Moonwolf711/generator-anc/firmware/README.md

# generator-anc firmware (Teensy 4.0/4.1)

Real-time engine-order ANC for a **Champion 4250** (224cc single-cylinder inverter genset)
on a Teensy 4.x + PJRC Audio Shield. The controller is `../include/eoc/engine_order_canceller.hpp`
(a synced copy lives in `generator_anc_teensy/` so the Arduino sketch can include it).

## What it does

- Reads the **error mic** through the Audio Shield codec.
- Reads the **spark tach** (one pulse/revolution) on an interrupt; interpolates crank angle and
  **phase-locks** the controller every audio block — the coherence that makes real cancellation work.
- Adapts a per-harmonic (cos/sin) anti-noise signal and plays it out the codec to a power amp/speaker.
- Tracks RPM live (essential — this is an inverter genset; engine speed swings with load).

## Bill of materials

| part | note |
|---|---|
| Teensy 4.0 or 4.1 | 600 MHz M7, the compute |
| PJRC Audio Shield (rev D, SGTL5000) | clean mic-in + line-out codec |
| Inductive spark pickup | clamps on the plug wire (timing-light style); no engine mod |
| Tach conditioning | clamp + comparator/transistor → **0/3.3 V** pulse (see below) |
| Electret/measurement mic | the error mic, into LINEIN |
| Class-D power amp + woofer | must reproduce ~30–360 Hz cleanly (a small subwoofer) |

## Wiring

```
spark plug wire ──[inductive clamp]──[diode+RC clamp]──[comparator → 0/3.3V]── Teensy pin 2 (TACH_PIN)
error mic ── Audio Shield LINEIN (L)
Audio Shield LINEOUT (L) ── power amp ── anti-noise speaker (near the error mic)
Teensy + Audio Shield: stack per PJRC pinout (I2S + I2C)
IMP 2 DI with GROUND LIFT on the line-level run to the amp -> kills the genset's 60 Hz ground-loop hum
```

**SAFETY — read this:**
- Teensy 4.x pins are **3.3 V only and NOT 5 V tolerant**. Never connect raw ignition voltage (kV)
  to a pin. The inductive pickup + clamp + comparator must deliver a clean 0–3.3 V pulse.
- A running generator emits **carbon monoxide** — bench/calibrate outdoors or with the engine off.
- The genset ground is dirty/possibly bonded-neutral; isolate line-level gear (the IMP 2 ground-lift)
  and don't create a shock path between the genset and your bench supply.

## Build

1. Install **Teensyduino** (Arduino IDE add-on).
2. Open `generator_anc_teensy/generator_anc_teensy.ino`. The controller header is already beside it.
   (To re-sync after editing the core: `cp ../../include/eoc/engine_order_canceller.hpp generator_anc_teensy/`.)
3. Board: Teensy 4.0/4.1, USB Type: Serial, CPU 600 MHz. Upload.
4. Open Serial Monitor (115200) — you'll see `f0`, RPM, per-order amplitudes, CPU%, and tach lock.

## No Audio Shield? (Teensy MQS + ADC) — `#define USE_AUDIO_SHIELD 0`

Teensy 4.0 has no DAC, but it can output audio via **MQS** (PWM) and read the mic via **ADC** — no
shield needed. For sub-bass anti-noise (30–360 Hz) MQS is plenty; its quantization noise is ultrasonic
and the amp + sub filter it out. Set `USE_AUDIO_SHIELD 0` (the default) and wire:

```
ANTI-NOISE OUT  Teensy pin 12 ──[1 kΩ]──┬──[1 µF]── amp RCA tip      (simple RC reconstruction filter)
                                        └──[10 nF]── GND
                Teensy GND ───────────────────────── amp RCA sleeve
MIC IN          electret mic ─ preamp (e.g. MAX9814, output ~1.25 V bias) ── Teensy A2 (pin 16)
```

- The mic **must** be biased into 0–3.3 V (a MAX9814 electret module does this for you). Never exceed 3.3 V on the pin.
- MQS lives on pins 10 & 12; use pin 12 (one channel) for a mono sub.
- Switch to `USE_AUDIO_SHIELD 1` later if you get the Rev D adaptor for cleaner I/O.

The controller **stays silent and does not adapt until it sees a valid tach** (engine sync). With no tach
the serial shows `orders[0.000…]` and `tach=--` — that's correct idle, not a fault.

## Calibration (REQUIRED for actual cancellation)

The controller needs the **secondary path** `Ŝ` — the speaker→error-mic magnitude and phase at each
harmonic. Without it, it won't cancel (and a 180°-wrong `Ŝ` makes it worse — proven in the unit tests).

**Automated (one key):** engine off, speaker + mic in final position, send **`c`** over the Serial
Monitor. The firmware sweeps each order, emits a probe tone from the sub, correlates the mic, fills
`Ŝ` automatically, prints the measured `mag`/`phase` per order, then drops into RUN. Takes ~1–2 s.
(The measurement math is verified by the desktop test `secondary_path_calibration_recovers_response`.)

It calibrates at `NOMINAL_CAL_RPM` (default 3000 → 50 Hz fundamental); `Ŝ` varies slowly with
frequency, so a single point per order is the v1. `setup()` still loads unity placeholders as a
fallback until you run `c`.

Amp settings during cal **must match the live run** (LPF max, bass-boost OFF, subsonic OFF, same gain)
— `Ŝ` captures the whole electrical+acoustic path including the amp, so changing it afterward invalidates
the calibration.

## How well it works / limits

- ANC creates a **local quiet zone** at the error mic (head-sized), not silence everywhere. Place the
  mic where the ears are.
- It cancels the **tones** (engine orders) — the drone — not broadband exhaust roar or wind.
- Expected: deep nulls at orders 1–6 once `Ŝ` is calibrated (the desktop sim hits 56–86 dB/order with a
  *realistic* `Ŝ`; real-world will be less, limited by `Ŝ` accuracy, speaker headroom, and mic placement).
- Sub-block tach interpolation is block-granular (~2.9 ms); fine for these RPMs. For very fast transients,
  refine to sample-accurate spark timestamping.
