Moonwolf711/generator-anc/docs/annotated_boards.png

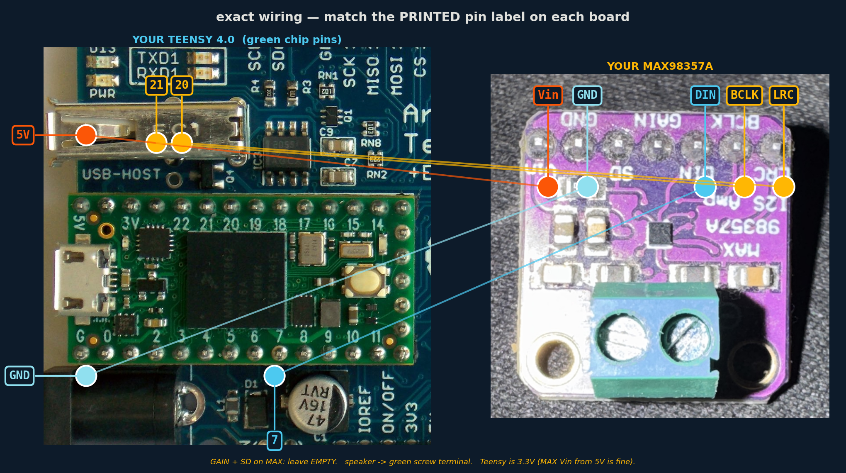
docs/annotated_boards.png
