Moonwolf711/generator-anc/docs/teensy_max98357a.png

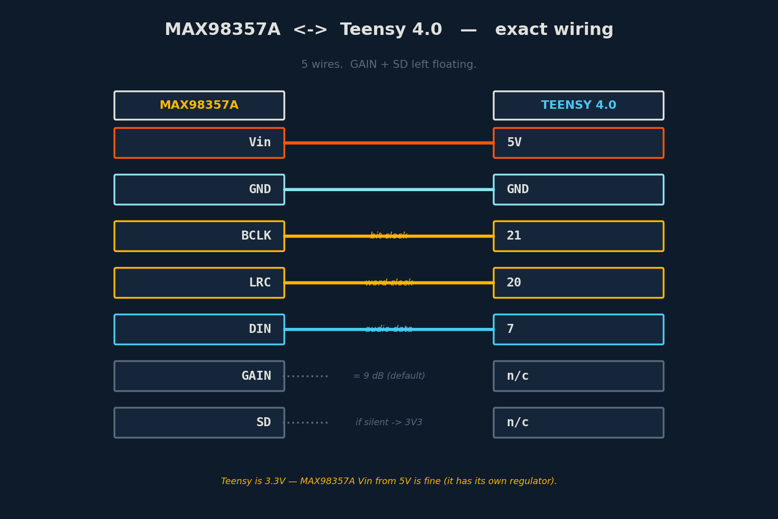
docs/teensy_max98357a.png
