Moonwolf711/generator-anc/docs/parts/speaker.jpg

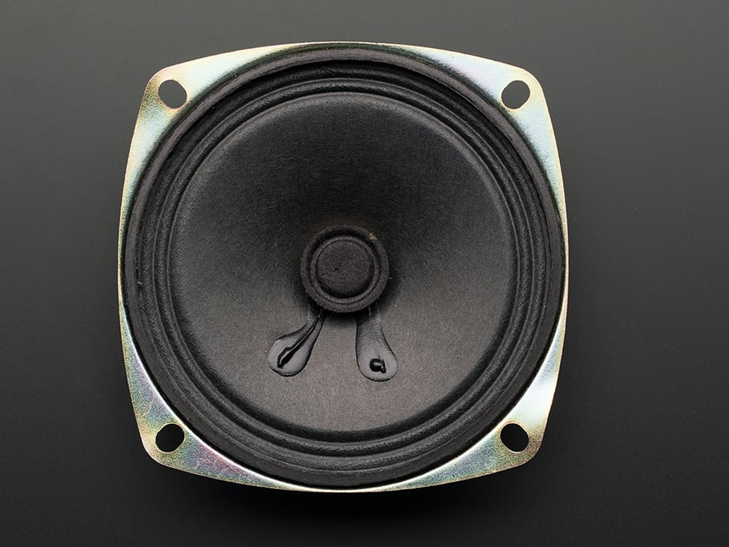
docs/parts/speaker.jpg
