Moonwolf711/generator-anc/webguide/assets/max_photo.jpg

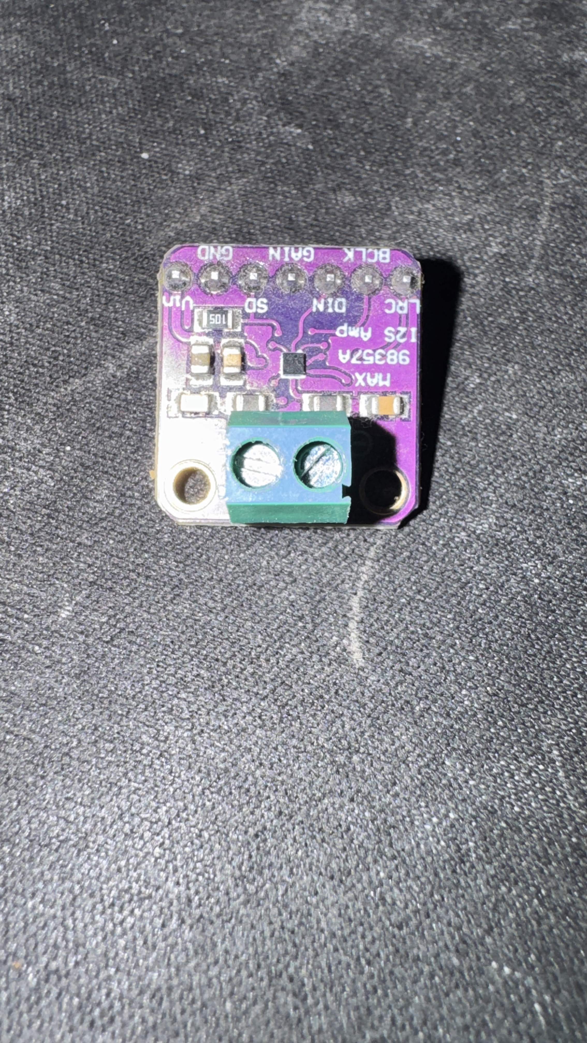
webguide/assets/max_photo.jpg
