Moonwolf711/generator-anc/webguide/assets/teensy_photo.jpg

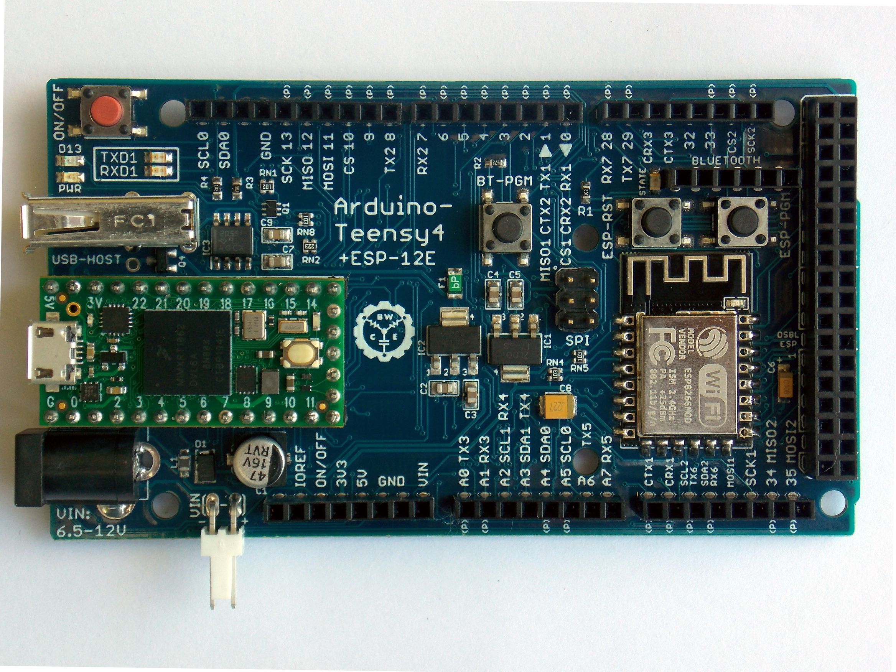
webguide/assets/teensy_photo.jpg
