Moonwolf711/generator-anc/(commit log)

2026-06-03 Engine-order ANC controller for generators (real-time C++17)
    Tach-synced narrowband FxLMS: per-harmonic 2-tap adaptive oscillator, per-order
    complex secondary path, trig-free hot loop (phasor recurrence), leaky normalized
    update. Header-only/embeddable, static build, -Wall -Wextra -Wpedantic clean.
    - 5/5 unit tests; synthetic genset validation +56..+86 dB per order with realistic S_hat.
    - replay_recording tool + analysis of a real genset recording.
    - Finding: engine-order ANC requires a clean tach phase reference; a single noise
    recording lacks one (free-running/estimated f0 decorrelates from real engine phase).
    Synthetic sim cancels deeply because its reference is phase-coherent by con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
    [engine_order_canceller.hpp]
2026-06-03 Add Teensy 4.x firmware + tach phase-lock (syncPhase)
    - core: syncPhase(theta0) re-seats oscillators to crank angle on each spark edge
    (the phase coherence missing from offline replay); referenceCos/Sin accessors; 6/6 tests.
    - firmware/generator_anc_teensy: Audio Shield (SGTL5000) EOC node, spark-tach ISR with
    cycle-accurate period + per-block crank-angle interpolation, RPM tracking, telemetry.
    - firmware/README: BOM, wiring, 3.3V tach-conditioning + CO/ground safety, S_hat calibration,
    ANC quiet-zone limits. Targets the Champion 4250 (224cc single, inverter, variable RPM).
    [engine_order_canceller.hpp, generator_anc_teensy.ino]
2026-06-04 Add engine-off S_hat auto-calibration (one-key 'c') + verified cal math
    - firmware: CALIBRATE mode sweeps each order, emits a probe tone, quadrature-correlates
    the mic to recover |S| and angle(S), fills setSecondaryPath, prints results, then RUN.
    Calibrates at NOMINAL_CAL_RPM; captures full amp+acoustic path.
    - test: secondary_path_calibration_recovers_response proves the quadrature measurement
    recovers a known FIR's response (mag within 2%, phase within 0.05 rad). 7/7 tests.
    - README: documents one-key cal + that amp settings must match the live run.
    - Hardware confirmed: 12in sealed sub + Alpine amp (LPF max, boost/subsonic OFF, separate 12V).
2026-06-04 Firmware: no-shield audio (MQS out + ADC in) toggle + tach gate
    - USE_AUDIO_SHIELD switch: 0 = Teensy MQS output (pins 10/12) + analog ADC mic in (A2),
    no Audio Shield needed; 1 = SGTL5000 Audio Adaptor. Both compile + flash on Teensy 4.0.
    - Tach gate: emit silence + freeze adaptation when no valid/fresh spark (no engine sync),
    preventing weight windup on a floating input. Verified on hardware: orders->0, cpu 1.5% idle.
    - README: no-shield wiring (output RC filter + MAX9814 mic preamp).
    Flashed + verified running on the actual Teensy 4.0 (serial telemetry confirmed).
    [generator_anc_teensy.ino]
2026-06-04 docs: wiring blueprint + animated cancellation demo
    - docs/blueprint.png: full no-shield rig (genset, spark tach, mic preamp, Teensy pins,
    RC filter, Alpine amp + 12in sub, power/ground) with every pin and part value.
    - docs/demo.gif: engine-order cancellation converging, per-order dB bars + residual collapse.
    - Generators (make_blueprint.py, make_demo.py) committed; embedded in README.
2026-06-04 Add ESP-12E WiFi telemetry: Teensy Serial1 CSV out + ESP8266 dashboard
    - Teensy firmware: stream compact CSV (ANC,f0,rpm,o1..o6,cpu,lock) on Serial1 to the
    onboard ESP-12E (BurgessWorld Arduino-Teensy4 carrier). Compiled + flashed.
    - firmware/esp12e_dashboard: ESP8266 sketch -> WiFi AP 'generator-anc' + live web
    dashboard (RPM, per-order effort bars, tach-lock, CPU). Off the critical path (monitoring).
2026-06-04 docs: annotated board pinout on the actual Teensy4+ESP-12E photo
    Marks the 5 generator-anc connections by silkscreen label: ANTI-NOISE OUT (MISO 12),
    TACH IN (2), MIC IN (A2), 3V3 (mic power), GND, plus the pre-wired ESP-12E Serial1 bridge.
2026-06-04 docs: end-to-end connection diagram (pin -> component terminal) + ESP Serial1 confirmed
    - docs/connections.png: every wire from each Teensy pin to the exact component terminal
    (MAX4466 OUT/VCC/GND, spark pickup, RC filter parts, Alpine amp RCA/SPKR/12V, sub, battery).
    - firmware comment: ESP on Serial1 CONFIRMED (Rev2 back silkscreen); pins 0/1 reserved.
    - README embeds blueprint + connections + board pinout.
2026-06-04 firmware: MAX98357A I2S output mode (user has this board)
    USE_MAX98357=1 -> AudioOutputI2S to the MAX98357A DAC+amp (BCLK 21, LRC 20, DIN 7) +
    analog ADC mic on A2. Cleaner output than MQS; drives a small 4-8ohm near-field speaker.
    MQS->Alpine->12in sub still available via USE_MAX98357=0.
2026-06-04 docs: photo wiring diagram (real device images + pin mapping)
    Composites the user's actual Teensy4+ESP board photo with real MAX4466 / MAX98357A /
    speaker images, with the MAX98357A-output pin mapping (21/20/7->BCLK/LRC/DIN, mic->A2).
2026-06-04 docs: photo wiring with SM58->Komplete mic chain (user's actual parts)
2026-06-04 docs: high-visibility photo wiring (signal-flow row + large connection tables)
2026-06-04 docs: lead README with clean photo_wiring; remove old cramped connections/board_pinout diagrams
2026-06-04 docs: exact MAX98357A<->Teensy pin-to-pin close-up (5 wires)
2026-06-04 docs: annotate the user's real Teensy + MAX98357A photos with the 5 output wires
2026-06-04 feat: interactive web wiring guide + live bench dashboard
    No-build React app (CDN React 18 + Babel) for the generator-ANC bench.
    Two screens: 5-wire Teensy->MAX98357A check-off guide with live board
    diagrams + real board photos, and a Live Bench dashboard with serial
    control sim (calibrate/run/stop), animated engine-order spectrum, and
    SS-confidence/reduction meters. Added index.html + style.css to make the
    provided source files runnable; color-scheme:dark to defeat auto-dark
    force-inversion.
2026-06-04 tools: fan/generator ANC bench test (record -> find engine orders -> offline cancel)
    Yeti-captured fan noise driven through an offline engine-order canceller.
    Empirically reproduces the project's core finding: cancellation collapses
    without a tach. Clean stable tone -22.5 dB; same tone drifting +/-4 Hz with
    a fixed-freq reference only -1.6 dB; with the true instantaneous frequency
    (a perfect tach) back to -22.4 dB. Real desk fan -4.1 dB (no tach + broadband).
    A fan is a generator minus the tach.
2026-06-04 feat(tach): spark pickup build guide + opto-isolated tach front-end
    - docs/spark-tach.md: inductive pickup -> PC817 opto -> Teensy pin 2, schematic,
    BOM, bring-up test, safety. The phase reference that moves the rig from the
    fan's -4 dB to the tach-locked 20 dB+/order regime.
    - firmware: TACH_PIN now INPUT_PULLUP + FALLING to match the open-collector opto
    (timestamps spark onset, line never floats). Header points to the build doc.
2026-06-04 feat(tools): --file mode + source-aware plot title
    Analyze any existing recording (iPhone .m4a, .mp3, .wav, .mov) instead of
    live mic capture; ffmpeg decodes + downmixes + resamples to 44.1k mono.
    Verified on the generator field recording: razor-sharp ~30 Hz firing-order
    comb out past 700 Hz -- the engine is far more tonal than the fan, the
    ideal case for engine-order ANC once a tach is in.
2026-06-04 feat(webguide): real generator spectrum + interactive param tuner
    Live Bench now opens on the REAL Champion 4250 capture (genset_spectrum.js,
    30.5 Hz comb baked from the field recording) with a Sim/Real-capture toggle.
    CaptureTuner: 4 live sliders (firing RPM, orders cancelled, cancellation
    depth, speaker cutoff) redraw the predicted residual + tonal-energy dB and
    the matching NUM_ORDERS/RPM firmware config. Planning preview, labeled as
    such. Verified in-browser: 12 orders @ 24 dB -> tonal energy -24.0 dB.
2026-06-04 feat(firmware): phone cockpit live mode with write-back
    - ESP-12E: serves a self-contained control page (live.html -> page_html.h, no CDN,
    SoftAP/no-internet), parses extended telemetry, adds /set + /cmd that forward
    commands back to the Teensy over the same full-duplex UART.
    - Teensy: dual-port (USB + ESP) line reader parses 'SET <p> <v>' and c/r/s, applies
    via the new canceller setters; telemetry CSV extended with mu,orders,gain,mode.
    - Cockpit verified in-browser against tools/mock_esp.py (live telemetry + slider
    write-back + buttons round-trip).
2026-06-04 docs: anti-noise output stage spec (MQS -> Alpine -> 12in sealed sub)
    The real output path for the genset (vs the MAX98357A bench speaker): RC low-pass +
    AC-couple into the Alpine line input, sealed-box rationale, zonal quiet-zone placement,
    Si-calibration handles polarity automatically, safe gain ramp via the cockpit slider,
    and IMP2 DI ground-lift for hum. Both firmware sketches compile clean; Teensy flashed
    and verified emitting telemetry (tach=-- as expected with no pickup yet).
2026-06-04 firmware: Teensy USB<->Serial1 passthrough for flashing the ESP-12E
    The ESP-12E has no direct USB -- it sits behind the Teensy on Serial1 (pins 0/1).
    This temporary bridge lets esptool reach the ESP through the Teensy (follows the
    host baud). Flash it, enter the ESP bootloader by hand (ESP-PGM + reset), flash the
    ESP with --before no_reset, then restore generator_anc_teensy.
    [esp_passthrough.ino]
2026-06-04 fix(cal): correct + harden the S_hat (secondary-path) calibration
    The routine existed but had two real bugs:
    - probed at NOMINAL_CAL_RPM=3000 (50-300 Hz) instead of this genset's 1830 RPM
    (30.5-183 Hz) -> S_hat measured at the wrong frequencies. Now 1830, and the cal
    RPM is settable live via 'SET cal_rpm <v>'.
    - stored |S|*CAL_AMP (0.3x) instead of |S| -- never divided by the probe amplitude,
    making the effective FxLMS step ~3.3x hot. Now divides by CAL_AMP.
    Hardening: floor stored |S| (S_FLOOR) so a weak order can't blow up the normalizer;
    'probe not heard' guard (S_HEARD) aborts + mutes + reports mode 4 'S-FAIL' if the
    amp/speaker/mic isn't delivering; prints each order's Hz + |S| +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
    [esp12e_dashboard.ino, generator_anc_teensy.ino]
2026-06-04 feat(cockpit): surface S_hat (secondary path) on the live phone page
    - canceller: secondaryMag(order) getter exposes the calibrated |S|.
    - Teensy: tracks calDone (successful calibration) and appends cal + per-order |S|
    to the telemetry CSV (...,mode,cal,s1..sN).
    - ESP: parses the new fields, adds cal + smag[] to /data JSON.
    - live.html: new 'S-hat - secondary path' card with per-order |S| bars and a
    calibrated/not-calibrated/FAIL status pill; mode pill turns red on S-FAIL.
    - mock_esp.py emits cal + smag for hardware-free verification.
    Verified all 3 states in-browser (calibrated bars, not-calibrated, S-FAIL red).
    9/9 tests; both sketches compile.
    [engine_order_canceller.hpp, esp12e_dashboard.ino, generator_anc_teensy.ino]
2026-06-04 chore: remove dead code and committed shell-artifact junk
    - delete 13 zero-byte files accidentally committed from shell redirects
    (0,1,GND,Hardware,Komplete,WiFi,amp,'amp)',component,green,kMinPeriodCyc,sub,the)
    - remove orphaned doc generators make_board_pinout.py + make_connections.py
    (their PNG outputs were deleted earlier; zero references remain)
2026-06-04 refactor(firmware): clear tachValid on stop, ISR-safe setters, hardening
    From the C++ review:
    - HIGH: tachValid was never cleared -> dashboard/mode showed 'running/lock' and the
    speaker stayed armed forever after the engine stopped. Now cleared in runProcess's
    stale branch (ISR re-sets on the next spark).
    - MED: wrap mu/orders/gain setters in AudioNoInterrupts (they race the audio update);
    kept the portable canceller class free of Teensy macros via thin AudioEOC wrappers.
    - LOW: floor |S| at kSFloor in setSecondaryPath (a zero would blow up the NLMS norm);
    bounds-check referenceCos/Sin like the other accessors.
    - ESP: parameterize NUM_ORDERS so the CSV protocol can't silently misalig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
2026-06-04 refactor(webguide): fix residual meter, DPR, interval leak, dead code
    From the React review:
    - HIGH: residual Meter passed max=0 -> (value/0) -> bar never filled. Added a min prop
    to Meter and pass min=-60 max=0 (dBFS), so it fills correctly.
    - HIGH: calibration sweep interval now stored in a ref + cleaned up on unmount (was
    leaking + calling setState on a dead component if you left mid-sweep).
    - MED: Tuner/Dashboard canvases use real devicePixelRatio; Tuner redraws on resize
    (ResizeObserver); moved Tuner's early-return after the hooks (rules-of-hooks).
    - LOW: removed dead sweepRef, unused 'empty' var, simplified redundant canRun.
2026-06-04 refactor(tools): resource-safe IO + dead code (from python review)
    - fan_anc_test.py: drop unused sys import and dead 'y' array; mktemp -> NamedTemporaryFile
    (TOCTOU); makedirs('captures') before writing. DSP math confirmed correct by review.
    - mock_esp.py: with-open file read; threading.Lock around shared S; 'stopped' mode string
    to match firmware vocab.
    - embed_page.py: wrap both opens in with-blocks.
2026-06-04 docs: bench bring-up runbook + refresh README
    - docs/bring-up-runbook.md: one ordered procedure (flash -> wire -> cockpit -> tach ->
    calibrate -> run -> tune) threading the spark-tach, output-stage, and Ŝ-cal docs.
    - README: add the hardware/firmware/phone-cockpit section, link the runbook, refresh the
    stale tach/limitations sections and the test count (now built, not theoretical).
